KeilToso/JAK-EE-chan/README.md

# JAK-EE-chan
EE 403W capstone project spring 2016

Keil Toso           ket156@psu.edu
Ahmad Mostafa       aam5532@psu.edu
Jeremy Doll         jwd5447@psu.edu
