KeilToso/JAK-EE-chan/SOFTWARE/FFT/FFT.ino

// FFT Test
//
// Compute a 1024 point Fast Fourier Transform (spectrum analysis)
// on audio connected to the Left Line-In pin.  By changing code,
// a synthetic sine wave can be input instead.
//
// The first 40 (of 512) frequency analysis bins are printed to
// the Arduino Serial Monitor.  Viewing the raw data can help you
// understand how the FFT works and what results to expect when
// using the data to control LEDs, motors, or other fun things!
//
// This example code is in the public domain.

#include <Audio.h>
#include <Wire.h>
#include <SPI.h>
#include <SD.h>
#include <SerialFlash.h>

const int myInput = AUDIO_INPUT_LINEIN;
//const int myInput = AUDIO_INPUT_MIC;

// Create the Audio components.  These should be created in the
// order data flows, inputs/sources -> processing -> outputs
//
AudioInputI2S          audioInput;         // audio shield: mic or line-in
AudioSynthWaveformSine sinewave;
AudioAnalyzeFFT1024    myFFT;
AudioOutputI2S         audioOutput;        // audio shield: headphones & line-out

// Connect either the live input or synthesized sine wave
AudioConnection patchCord1(audioInput, 0, myFFT, 0);
//AudioConnection patchCord1(sinewave, 0, myFFT, 0);

AudioControlSGTL5000 audioShield;

void setup() {
  // Audio connections require memory to work.  For more
  // detailed information, see the MemoryAndCpuUsage example



  /* 
   *  
   *  AudioConnection myConnection(source, destination);
Route audio data from the source object's output 0, to the destination object's input 0. This shorter form is convenient when using objects with only a single input and output.
AudioMemory(numberBlocks);
Allocate the memory for all audio connections. The numberBlocks input specifies how much memory to reserve for audio data. Each block holds 128 audio samples, or approx 2.9 ms of sound. Usually an initial guess is made for numberBlocks and the actual usage is checked with AudioMemoryUsageMax().
AudioMemoryUsage();
Returns the number of blocks currently in use.
AudioMemoryUsageMax();
Return the maximum number of blocks that have ever been used. This is by far the most useful function for monitoring memory usage.
AudioMemoryUsageMaxReset();
Reset the maximum reported by AudioMemoryUsageMax. If you wish to discover the worst case usage over a period of time, this may be used at the beginning and then the maximum can be read.
   *  
   *  
   */
  AudioMemory(12);

  // Enable the audio shield and set the output volume.
  audioShield.enable();
  audioShield.inputSelect(myInput);
  audioShield.volume(0.5);

  // Configure the window algorithm to use
  myFFT.windowFunction(AudioWindowHanning1024);

}

void loop() {
  float n;
  int i;

  if (myFFT.available()) {
    // each time new FFT data is available
    // print it all to the Arduino Serial Monitor
    Serial.print("FFT: ");
    for (i=0; i<490; i++) {
      n = myFFT.read(i);
      if (n >= 0.01) {
        Serial.print(n);
        Serial.print(" ");
      } else {
        Serial.print("  -  "); // don't print "0.00"
      }
    }
    Serial.println();
  }
}
