KeilToso/JAK-EE-chan/(commit log)

2016-01-22 Create C:\Users\Jeremy\Documents\School Work\Spring 2016\EE 403W
2016-04-13 button testing with LED's
2016-04-26 Add PCB documentation
